mengstr/mxe11/README.md

# MXE11 - Run UNIX on a microcontroller 

This is a copy of a project by Joerg Wolfram found at [jcwolfram.de/projekte/mxe11](http://www.jcwolfram.de/projekte/mxe11_en/main.php)
