mengstr/mxe11/(list of files, drawings)

Other design files:
doc/stm32f405_3.pcb
