mengstr/mxe11/src/inc/cpu_stage2_tables.h

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
//##############################################################################
//# prototypes
//##############################################################################
void stage2_undf(void);

void stage2_0000(void);void stage2_0001(void);void stage2_0002(void);void stage2_0003(void);
void stage2_0004(void);void stage2_0005(void);void stage2_0006(void);void stage2_0007(void);
void stage2_0010(void);void stage2_0011(void);void stage2_0012(void);void stage2_0013(void);
void stage2_0014(void);void stage2_0015(void);void stage2_0016(void);void stage2_0017(void);
void stage2_0020(void);void stage2_0021(void);void stage2_0022(void);void stage2_0023(void);
void stage2_0024(void);void stage2_0025(void);void stage2_0026(void);void stage2_0027(void);
void stage2_0030(void);void stage2_0031(void);void stage2_0032(void);void stage2_0033(void);
void stage2_0034(void);void stage2_0035(void);void stage2_0036(void);void stage2_0037(void);
void stage2_0040(void);void stage2_0041(void);void stage2_0042(void);void stage2_0043(void);
void stage2_0044(void);void stage2_0045(void);void stage2_0046(void);void stage2_0047(void);
void stage2_0050(void);void stage2_0051(void);void stage2_0052(void);void stage2_0053(void);
void stage2_0054(void);void stage2_0055(void);void stage2_0056(void);void stage2_0057(void);
void stage2_0060(void);void stage2_0061(void);void stage2_0062(void);void stage2_0063(void);
void stage2_0064(void);void stage2_0067(void);
void stage2_0070(void);void stage2_0071(void);void stage2_0072(void);void stage2_0073(void);
void stage2_0074(void);void stage2_0075(void);void stage2_0076(void);void stage2_0077(void);
void stage2_0700(void);void stage2_0701(void);void stage2_0702(void);void stage2_0703(void);
void stage2_0704(void);void stage2_0705(void);void stage2_0706(void);void stage2_0707(void);
void stage2_0710(void);void stage2_0711(void);void stage2_0712(void);void stage2_0713(void);
void stage2_0714(void);void stage2_0715(void);void stage2_0716(void);void stage2_0717(void);
void stage2_0720(void);void stage2_0721(void);void stage2_0722(void);void stage2_0723(void);
void stage2_0724(void);void stage2_0725(void);void stage2_0726(void);void stage2_0727(void);
void stage2_0730(void);void stage2_0731(void);void stage2_0732(void);void stage2_0733(void);
void stage2_0734(void);void stage2_0735(void);void stage2_0736(void);void stage2_0737(void);
void stage2_0740(void);void stage2_0741(void);void stage2_0742(void);void stage2_0743(void);
void stage2_0744(void);void stage2_0745(void);void stage2_0746(void);void stage2_0747(void);
void stage2_0750(void);void stage2_0751(void);void stage2_0752(void);void stage2_0753(void);
void stage2_0754(void);void stage2_0755(void);void stage2_0756(void);void stage2_0757(void);
void stage2_0760(void);void stage2_0761(void);void stage2_0762(void);void stage2_0763(void);
void stage2_0764(void);void stage2_0765(void);void stage2_0766(void);void stage2_0767(void);
void stage2_0770(void);void stage2_0771(void);void stage2_0772(void);void stage2_0773(void);
void stage2_0774(void);void stage2_0775(void);void stage2_0776(void);void stage2_0777(void);

void stage2_1000(void);void stage2_1001(void);void stage2_1002(void);void stage2_1003(void);
void stage2_1004(void);void stage2_1005(void);void stage2_1006(void);void stage2_1007(void);
void stage2_1010(void);void stage2_1011(void);void stage2_1012(void);void stage2_1013(void);
void stage2_1014(void);void stage2_1015(void);void stage2_1016(void);void stage2_1017(void);
void stage2_1020(void);void stage2_1021(void);void stage2_1022(void);void stage2_1023(void);
void stage2_1024(void);void stage2_1025(void);void stage2_1026(void);void stage2_1027(void);
void stage2_1030(void);void stage2_1031(void);void stage2_1032(void);void stage2_1033(void);
void stage2_1034(void);void stage2_1035(void);void stage2_1036(void);void stage2_1037(void);
void stage2_1040(void);void stage2_1041(void);void stage2_1042(void);void stage2_1043(void);
void stage2_1044(void);void stage2_1045(void);void stage2_1046(void);void stage2_1047(void);
void stage2_1050(void);void stage2_1051(void);void stage2_1052(void);void stage2_1053(void);
void stage2_1054(void);void stage2_1055(void);void stage2_1056(void);void stage2_1057(void);
void stage2_1060(void);void stage2_1061(void);void stage2_1062(void);void stage2_1063(void);
void stage2_1064(void);void stage2_1067(void);
void stage2_1070(void);void stage2_1071(void);void stage2_1072(void);void stage2_1073(void);
void stage2_1074(void);void stage2_1075(void);void stage2_1076(void);void stage2_1077(void);

void stage2_1700(void);void stage2_1701(void);void stage2_1702(void);void stage2_1703(void);
void stage2_1704(void);void stage2_1705(void);void stage2_1706(void);void stage2_1707(void);
void stage2_1710(void);void stage2_1711(void);void stage2_1712(void);void stage2_1713(void);
void stage2_1714(void);void stage2_1715(void);void stage2_1716(void);void stage2_1717(void);
void stage2_1720(void);void stage2_1721(void);void stage2_1722(void);void stage2_1723(void);
void stage2_1724(void);void stage2_1725(void);void stage2_1726(void);void stage2_1727(void);
void stage2_1730(void);void stage2_1731(void);void stage2_1732(void);void stage2_1733(void);
void stage2_1734(void);void stage2_1735(void);void stage2_1736(void);void stage2_1737(void);
void stage2_1740(void);void stage2_1741(void);void stage2_1742(void);void stage2_1743(void);
void stage2_1744(void);void stage2_1745(void);void stage2_1746(void);void stage2_1747(void);
void stage2_1750(void);void stage2_1751(void);void stage2_1752(void);void stage2_1753(void);
void stage2_1754(void);void stage2_1755(void);void stage2_1756(void);void stage2_1757(void);
void stage2_1760(void);void stage2_1761(void);void stage2_1762(void);void stage2_1763(void);
void stage2_1764(void);void stage2_1765(void);void stage2_1766(void);void stage2_1767(void);
void stage2_1770(void);void stage2_1771(void);void stage2_1772(void);void stage2_1773(void);
void stage2_1774(void);void stage2_1775(void);void stage2_1776(void);void stage2_1777(void);


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
	stage2_undf,	stage2_undf,	// 1762 1763
	stage2_undf,	stage2_undf,	// 1764 1765
	stage2_undf,	stage2_undf,	// 1766 1767
	stage2_undf,	stage2_undf,	// 1770 1771
	stage2_undf,	stage2_undf,	// 1772 1773
	stage2_undf,	stage2_undf,	// 1774 1775
	stage2_undf,	stage2_undf	// 1776 1777
};
