mengstr/mxe11/src/inc/ctable_06_10.h

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
	0x00,0x00,0x00,0x00,0x00,0x00,0x00,0x00,0x00,0x00,
	0xe0,0xe0,0xe0,0xe0,0xe0,0x00,0x00,0x00,0x00,0x00,
	0x1c,0x1c,0x1c,0x1c,0x1c,0x00,0x00,0x00,0x00,0x00,
	0xfc,0xfc,0xfc,0xfc,0xfc,0x00,0x00,0x00,0x00,0x00,
	0x00,0x00,0x00,0x00,0x00,0xe0,0xe0,0xe0,0xe0,0xe0,
	0xe0,0xe0,0xe0,0xe0,0xe0,0xe0,0xe0,0xe0,0xe0,0xe0,
	0x1c,0x1c,0x1c,0x1c,0x1c,0xe0,0xe0,0xe0,0xe0,0xe0,
	0xfc,0xfc,0xfc,0xfc,0xfc,0xe0,0xe0,0xe0,0xe0,0xe0,
	0x00,0x00,0x00,0x00,0x00,0x1c,0x1c,0x1c,0x1c,0x1c,
	0xe0,0xe0,0xe0,0xe0,0xe0,0x1c,0x1c,0x1c,0x1c,0x1c,
	0x1c,0x1c,0x1c,0x1c,0x1c,0x1c,0x1c,0x1c,0x1c,0x1c,
	0xfc,0xfc,0xfc,0xfc,0xfc,0x1c,0x1c,0x1c,0x1c,0x1c,
	0x00,0x00,0x00,0x00,0x00,0xfc,0xfc,0xfc,0xfc,0xfc,
	0xe0,0xe0,0xe0,0xe0,0xe0,0xfc,0xfc,0xfc,0xfc,0xfc,
	0x1c,0x1c,0x1c,0x1c,0x1c,0xfc,0xfc,0xfc,0xfc,0xfc,
	0xfc,0xfc,0xfc,0xfc,0xfc,0xfc,0xfc,0xfc,0xfc,0xfc,
	0xa8,0x54,0xa8,0x54,0xa8,0x54,0xa8,0x54,0xa8,0x54,
	0x30,0x78,0x78,0xfc,0xfc,0xfc,0xfc,0x78,0x78,0x30,
	0x30,0x78,0x78,0xfc,0xfc,0xfc,0xfc,0xfc,0xfc,0xfc,
	0xfc,0xfc,0xfc,0xfc,0xfc,0xfc,0xfc,0x78,0x78,0x30,
	0x04,0xcc,0xfc,0xfc,0xdc,0x1c,0x1c,0x18,0x18,0x18,
	0x80,0xcc,0xfc,0xfc,0xec,0xe0,0xe0,0x60,0x60,0x60,
	0x18,0x18,0x18,0x1c,0x1c,0xdc,0xfc,0xfc,0xcc,0x1c,
	0x60,0x60,0x60,0xe0,0xe0,0xec,0xfc,0xfc,0xcc,0xe0,
	0x30,0x70,0x78,0xf8,0xfc,0x7c,0xf8,0x78,0x7c,0xfc,
	0x00,0x38,0x44,0x44,0x78,0x44,0x44,0x78,0x40,0x40,
	0x00,0x30,0x30,0x00,0x78,0x00,0x30,0x30,0x00,0x00,
	0x00,0x00,0x04,0x78,0x28,0x28,0x28,0x28,0x00,0x00,
	0x00,0x38,0x28,0x38,0x00,0x00,0x00,0x00,0x00,0x00,
	0x00,0x00,0x00,0x10,0x28,0x7c,0x00,0x00,0x00,0x00,
	0x00,0x00,0x00,0x24,0x24,0x24,0x24,0x38,0x20,0x40,
	0x00,0x00,0x00,0x38,0x44,0x44,0x28,0x6c,0x00,0x00,
	0x00,0x00,0x00,0x00,0x00,0x00,0x00,0x00,0x00,0x00,
	0x00,0x10,0x10,0x10,0x10,0x10,0x00,0x10,0x00,0x00,
	0x00,0x28,0x28,0x28,0x00,0x00,0x00,0x00,0x00,0x00,
	0x00,0x28,0x28,0x7c,0x28,0x7c,0x28,0x28,0x00,0x00,
	0x00,0x10,0x3c,0x50,0x38,0x14,0x78,0x10,0x00,0x00,
	0x00,0x60,0x64,0x08,0x10,0x20,0x4c,0x0c,0x00,0x00,
	0x00,0x30,0x48,0x50,0x20,0x50,0x48,0x34,0x00,0x00,
	0x00,0x30,0x10,0x20,0x00,0x00,0x00,0x00,0x00,0x00,
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
};
