mengstr/mxe11/src/inc/itest1_data.h

const unsigned short itest1_data[9728]= {
0x0107,0x1c72,0x0000,0x0000,0x0f18,0x0000,0x0000,0x0000,0x0002,0x0000,0x0006,0x0000,0x000a,0x0000,0x000e,0x0000,
0x0012,0x0000,0x0016,0x0000,0x1a08,0x0000,0x1b5a,0x0000,0x0022,0x0000,0x0026,0x0000,0x002a,0x0000,0x002e,0x0000,
0x0032,0x0000,0x0036,0x0000,0x003a,0x0000,0x003e,0x0000,0x0000,0x0000,0x0000,0x0000,0x0000,0x0000,0x0000,0x0000,
0x0000,0x0000,0x0000,0x0000,0x0000,0x0000,0x0000,0x0000,0x0000,0x0000,0x0000,0x0000,0x0000,0x0000,0x0000,0x0000,
0x0000,0x0000,0x0000,0x0000,0x0000,0x0000,0x0000,0x0000,0x15c6,0x1c4c,0x15f7,0x0080,0x1afc,0x15f7,0x0800,0x1af2,
0x8900,0x15c0,0xfff8,0x2c17,0x1bec,0xaaaa,0x0301,0x8800,0x8900,0x15c0,0xfff8,0x25f0,0xaaaa,0x1bec,0x0301,0x8800,
0x8900,0x15c0,0x0008,0x2c17,0x1bec,0x5555,0x0301,0x8800,0x8900,0x15c0,0x0008,0x25f0,0x5555,0x1bec,0x0301,0x8800,
0x8900,0x15c0,0xfff8,0x2c30,0x1bec,0x1bec,0x0301,0x8800,0x8900,0x15c0,0x0008,0x2c30,0x1bec,0x1bec,0x0301,0x8800,
0x8900,0x15c0,0xfff8,0x15c1,0x0004,0x2c31,0x1bec,0x1bec,0x0301,0x8800,0x8900,0x2c70,0x1bec,0x1bec,0x0301,0x8800,
0x8900,0x15c0,0xfffc,0x15c1,0x0008,0x2c31,0x1bec,0x1bec,0x0301,0x8800,0x8900,0x15c0,0xfffc,0x15c1,0x0008,0x2c70,
0x1bec,0x1bec,0x0301,0x8800,0x8900,0x15c0,0xfff8,0x1c37,0x1bec,0x1aba,0x2dd7,0x1ab6,0xaaaa,0x0301,0x8800,0x8900,
0x15c0,0x0008,0x1c37,0x1bec,0x1aa4,0x2dd7,0x1aa0,0x5555,0x0301,0x8800,0x8900,0x15c0,0xfff8,0x15f0,0xaaaa,0x1bfe,
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
0x8900,0x0a37,0x1748,0x65df,0xaaaa,0x1bfe,0x25f7,0xaaaa,0x173c,0x0301,0x8800,0x15f7,0xaaaa,0x1732,0x6fdf,0x1722,
0x1bfe,0x2dd7,0x1728,0xffff,0x0301,0x8800,0x8900,0x15f7,0xffff,0x171a,0x0a1f,0x1bfe,0x0bf7,0x1712,0x0301,0x8800,
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
