mengstr/mxe11/(notices)

Notices in the files:
src/inc/cpu.h:
copyright (c) 2017-2018 Joerg Wolfram (joerg@jcwolfram.de)
